aherbez/game2/microgame2.kicad_pcb

## KiCad design microgame2.kicad_pcb (2024-06-25)

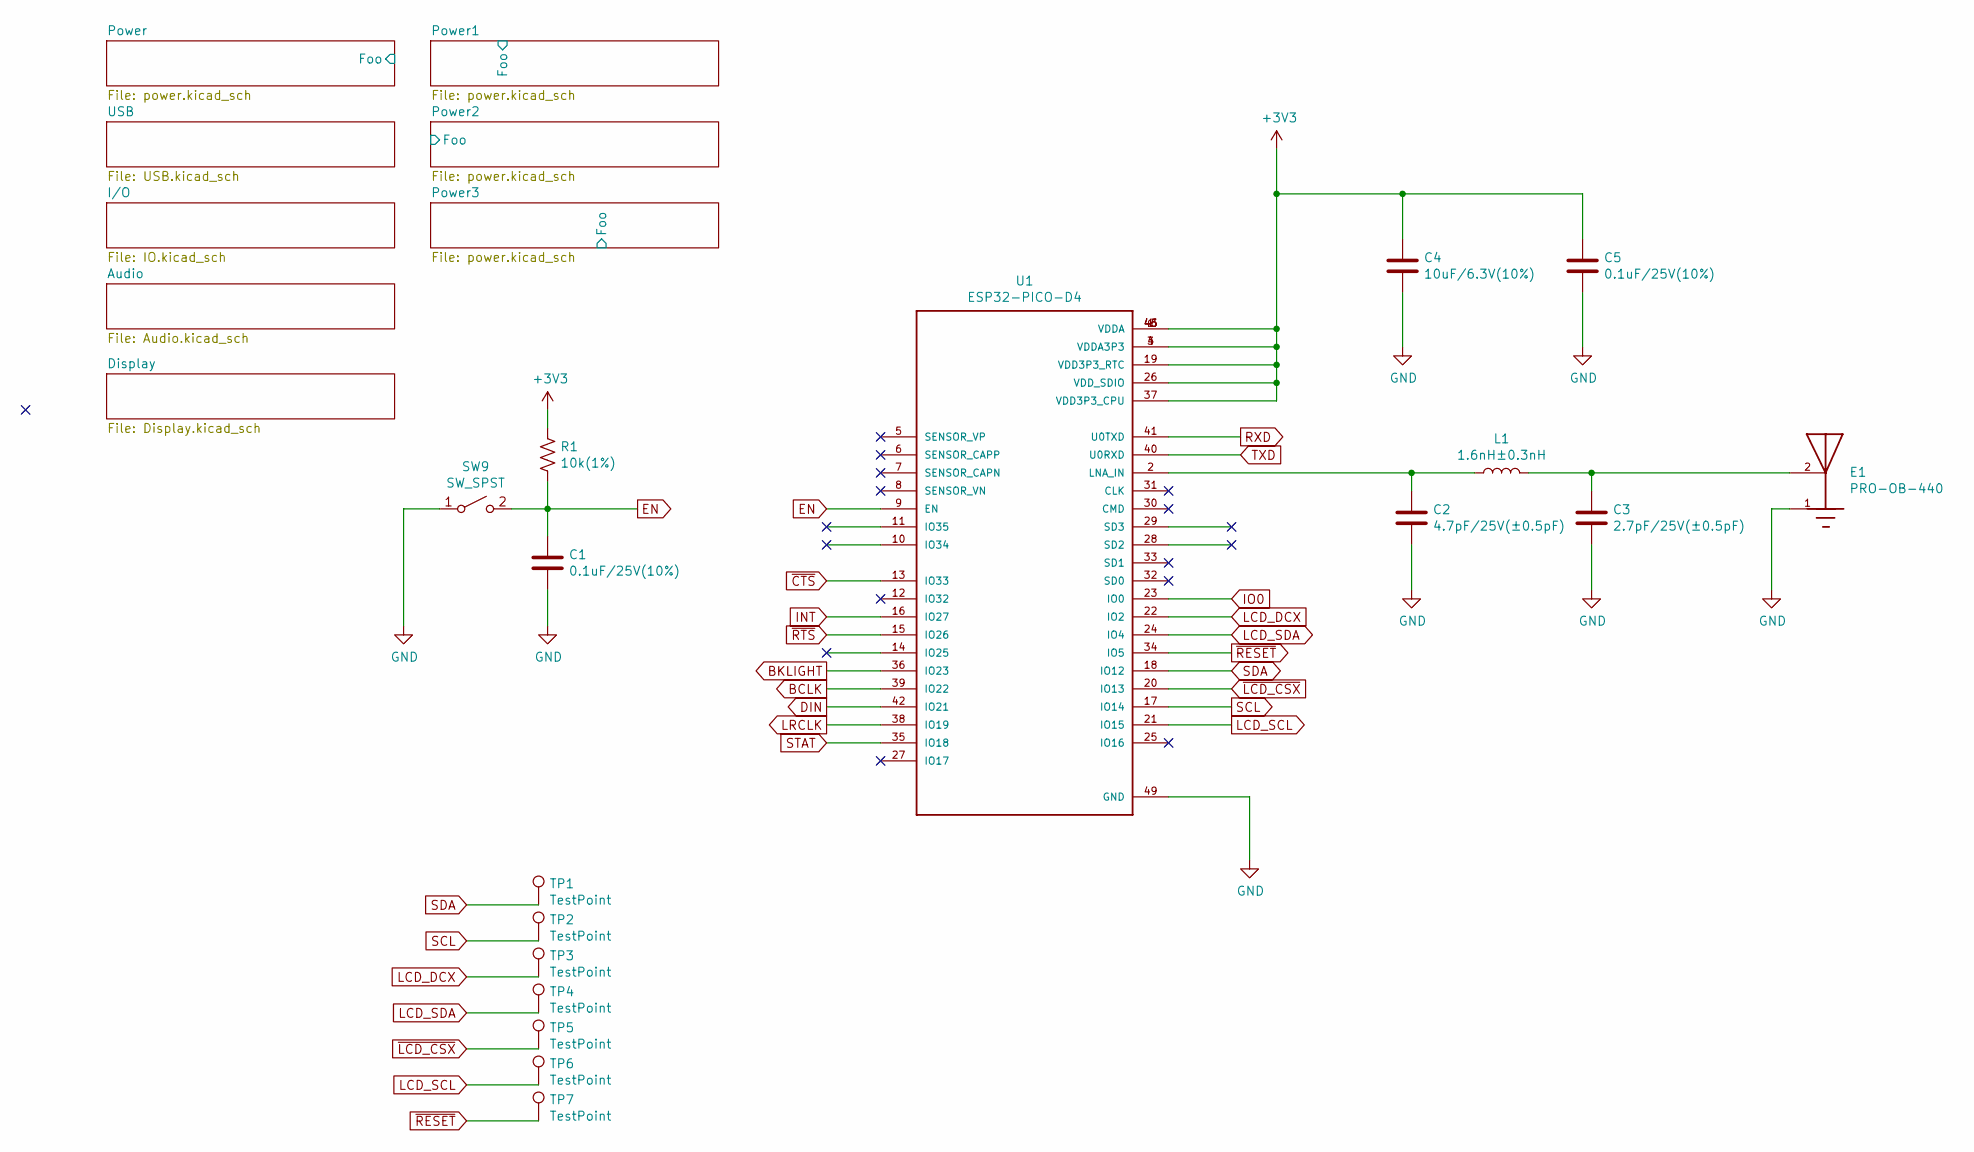
[picture p1: schematic microgame2.kicad_sch]

Parts:
C1, C5: 0.1uF/25V(10%); C_0402_1005Metric
C2: 4.7pF/25V(±0.5pF); C_0402_1005Metric
C3: 2.7pF/25V(±0.5pF); C_0402_1005Metric
C4: 10uF/6.3V(10%); C_0603_1608Metric
E1: PRO-OB-440; ANT_PRO-OB-440
L1: 1.6nH±0.3nH; C_0402_1005Metric
R1: 10k(1%); C_0402_1005Metric
SW9: SW_SPST; EVPAE
TP1, TP2, TP3, TP4, TP5, TP6, TP7: TestPoint; TestPoint_Pad_D1.0mm
U1: ESP32-PICO-D4; PQFN50P700X700X104-49N

Connections:
+3V3: C4.1, C5.1, R1.1, U1.1 (VDDA), U1.3 (VDDA3P3), U1.4 (VDDA3P3), U1.19 (VDD3P3_RTC), U1.26 (VDD_SDIO), U1.37 (VDD3P3_CPU), U1.43 (VDDA), U1.46 (VDDA); also elsewhere on the board
BCLK: U1.39 (IO22); also elsewhere on the board
BKLIGHT: U1.36 (IO23); also elsewhere on the board
DIN: U1.42 (IO21); also elsewhere on the board
EN: C1.1, R1.2, SW9.2 (B), U1.9 (EN); also elsewhere on the board
GND: C1.2, C2.2, C3.2, C4.2, C5.2, E1.1, SW9.1 (A), U1.49 (GND); also elsewhere on the board
INT: U1.16 (IO27); also elsewhere on the board
IO0: U1.23 (IO0); also elsewhere on the board
LCD_DCX: TP3.1, U1.22 (IO2); also elsewhere on the board
LCD_SCL: TP6.1, U1.21 (IO15); also elsewhere on the board
LCD_SDA: TP4.1, U1.24 (IO4); also elsewhere on the board
LRCLK: U1.38 (IO19); also elsewhere on the board
unnamed: C2.1, L1.1, U1.2 (LNA_IN)
unnamed: C3.1, E1.2, L1.2
RXD: U1.41 (U0TXD); also elsewhere on the board
SCL: TP2.1, U1.17 (IO14); also elsewhere on the board
SDA: TP1.1, U1.18 (IO12); also elsewhere on the board
STAT: U1.35 (IO18); also elsewhere on the board
TXD: U1.40 (U0RXD); also elsewhere on the board
~CTS: U1.13 (IO33); also elsewhere on the board
~LCD_CSX: TP5.1, U1.20 (IO13); also elsewhere on the board
~RESET: TP7.1, U1.34 (IO5); also elsewhere on the board
~RTS: U1.15 (IO26); also elsewhere on the board

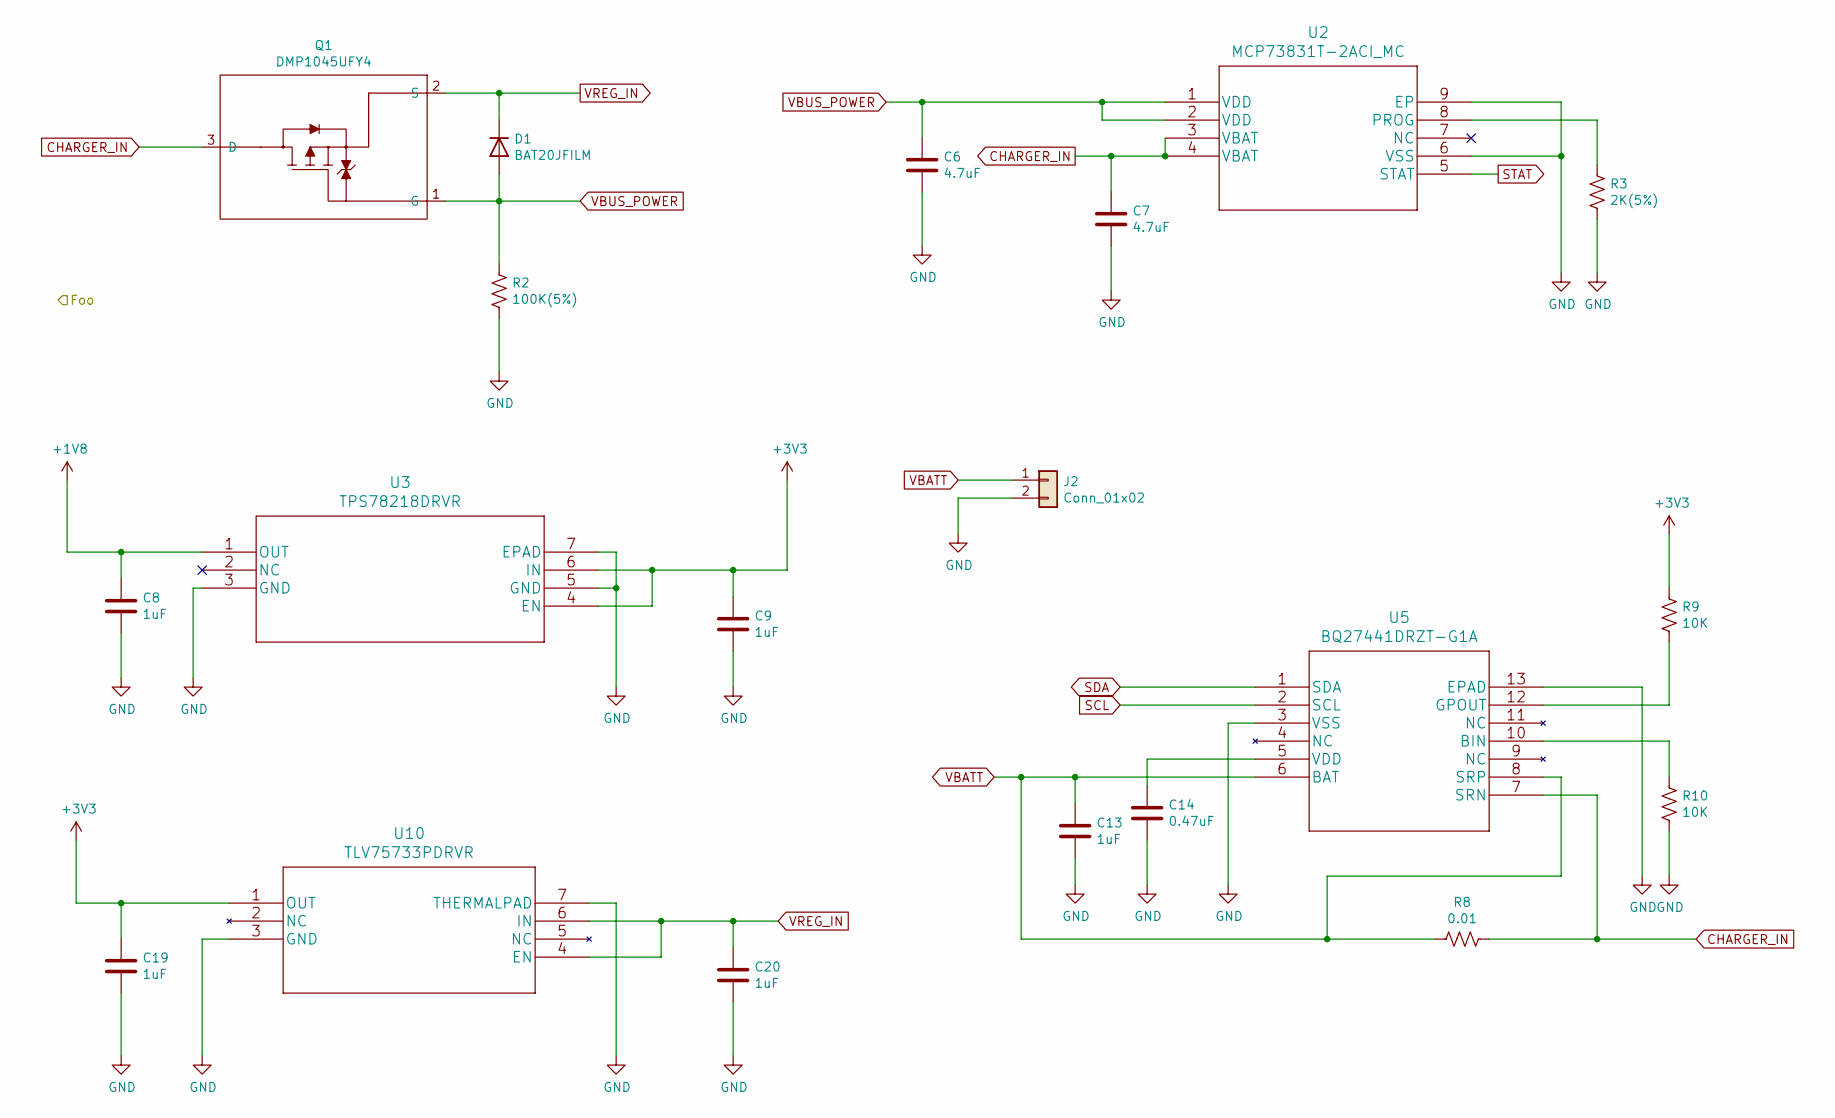
[picture p2: schematic power.kicad_sch]

Parts:
C6, C7: 4.7uF; R_0603_1608Metric
C8, C9, C13, C19, C20: 1uF; R_0603_1608Metric
C14: 0.47uF; R_0402_1005Metric
D1: ‎BAT20JFILM; BAT20JFILM
J2: Conn_01x02; R_1206_3216Metric
Q1: DMP1045UFY4; X2-DFN2015-3
R2: 100K(5%); R_0402_1005Metric
R3: 2K(5%); R_0402_1005Metric
R8: 0.01; R_1206_3216Metric
R9, R10: 10K; R_0402_1005Metric
U2: MCP73831T-2ACI_MC; MCP73831T-2ACI&slash_MC
U3: TPS78218DRVR
U5: BQ27441DRZT-G1A
U10: TLV75733PDRVR

Connections:
+1V8: C8.1, U3.1 (OUT); also elsewhere on the board
+3V3: C9.1, C19.1, R9.1, U3.4 (EN), U3.6 (IN), U10.1 (OUT); also elsewhere on the board
CHARGER_IN: C7.1, Q1.3 (D), R8.1, U2.3 (VBAT), U2.4 (VBAT), U5.7 (SRN)
GND: C6.2, C7.2, C8.2, C9.2, C13.2, C14.2, C19.2, C20.2, J2.2, R2.2, R3.2, R10.2, U2.6 (VSS), U2.9 (EP), U3.3 (GND), U3.5 (GND), U3.7 (EPAD), U5.3 (VSS), U5.13 (EPAD), U10.3 (GND), U10.7 (THERMALPAD); also elsewhere on the board
unnamed: C14.1, U5.5 (VDD)
unnamed: R3.1, U2.8 (PROG)
unnamed: R9.2, U5.12 (GPOUT)
unnamed: R10.1, U5.10 (BIN)
SCL: U5.2 (SCL); also elsewhere on the board
SDA: U5.1 (SDA); also elsewhere on the board
STAT: U2.5 (STAT); also elsewhere on the board
VBATT: C13.1, J2.1, R8.2, U5.6 (BAT), U5.8 (SRP)
VBUS_POWER: C6.1, D1.2 (A), Q1.1 (G), R2.1, U2.1 (VDD), U2.2 (VDD); also elsewhere on the board
VREG_IN: C20.1, D1.1 (K), Q1.2 (S), U10.4 (EN), U10.6 (IN)

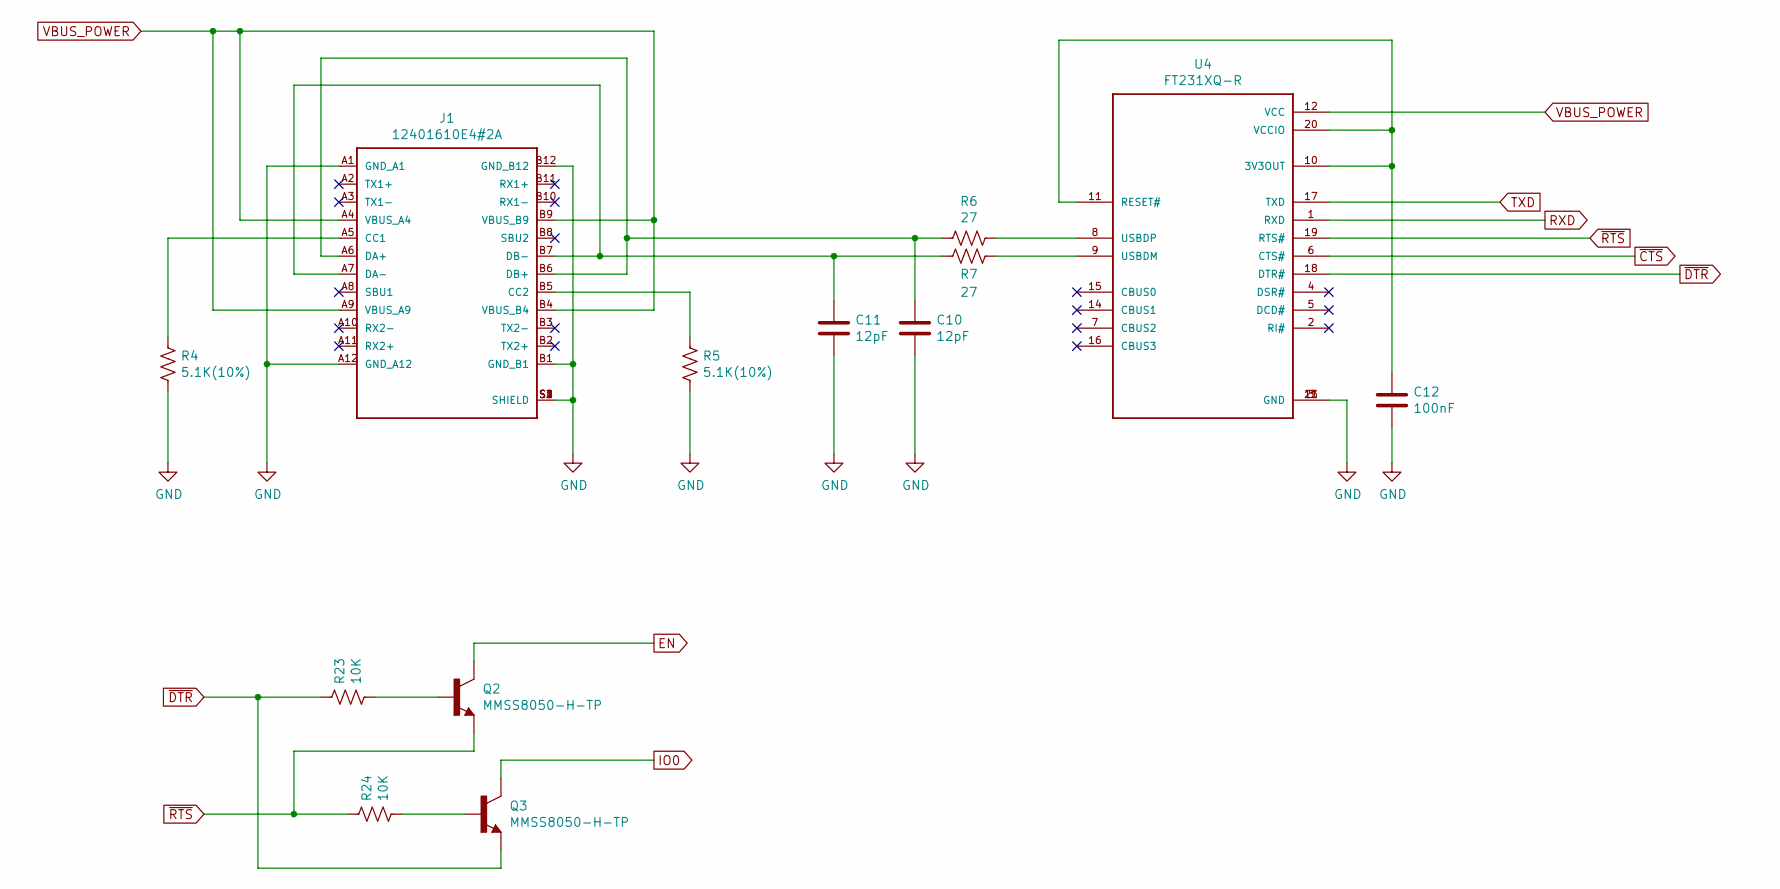
[picture p3: schematic USB.kicad_sch]

Parts:
C10, C11: 12pF; R_0402_1005Metric
C12: 100nF; R_0402_1005Metric
J1: 12401610E4#2A; AMPHENOL_12401610E4#2A
Q2, Q3: MMSS8050-H-TP; TRANS_MMSS8050-H-TP
R4, R5: 5.1K(10%); R_0402_1005Metric
R6, R7: 27; R_0402_1005Metric
R23, R24: 10K; R_0402_1005Metric
U4: FT231XQ-R; QFN50P400X400X80-21N

Connections:
EN: Q2.3; also elsewhere on the board
GND: C10.2, C11.2, C12.2, J1.A1 (GND_A1), J1.A12 (GND_A12), J1.B1 (GND_B1), J1.B12 (GND_B12), J1.S1 (SHIELD), J1.S2 (SHIELD), J1.S3 (SHIELD), J1.S4 (SHIELD), R4.1, R5.1, U4.3 (GND), U4.13 (GND), U4.21 (GND); also elsewhere on the board
IO0: Q3.3; also elsewhere on the board
unnamed: C10.1, J1.A6 (DA+), J1.B6 (DB+), R6.2
unnamed: C11.1, J1.A7 (DA-), J1.B7 (DB-), R7.2
unnamed: C12.1, U4.10 (3V3OUT), U4.11 (RESET#), U4.20 (VCCIO)
unnamed: J1.A5 (CC1), R4.2
unnamed: J1.B5 (CC2), R5.2
unnamed: Q2.1, R23.1
unnamed: Q3.1, R24.1
unnamed: R6.1, U4.8 (USBDP)
unnamed: R7.1, U4.9 (USBDM)
RXD: U4.1 (RXD); also elsewhere on the board
TXD: U4.17 (TXD); also elsewhere on the board
VBUS_POWER: J1.A4 (VBUS_A4), J1.A9 (VBUS_A9), J1.B4 (VBUS_B4), J1.B9 (VBUS_B9), U4.12 (VCC); also elsewhere on the board
~CTS: U4.6 (CTS#); also elsewhere on the board
~DTR: Q3.2, R23.2, U4.18 (DTR#)
~RTS: Q2.2, R24.2, U4.19 (RTS#); also elsewhere on the board

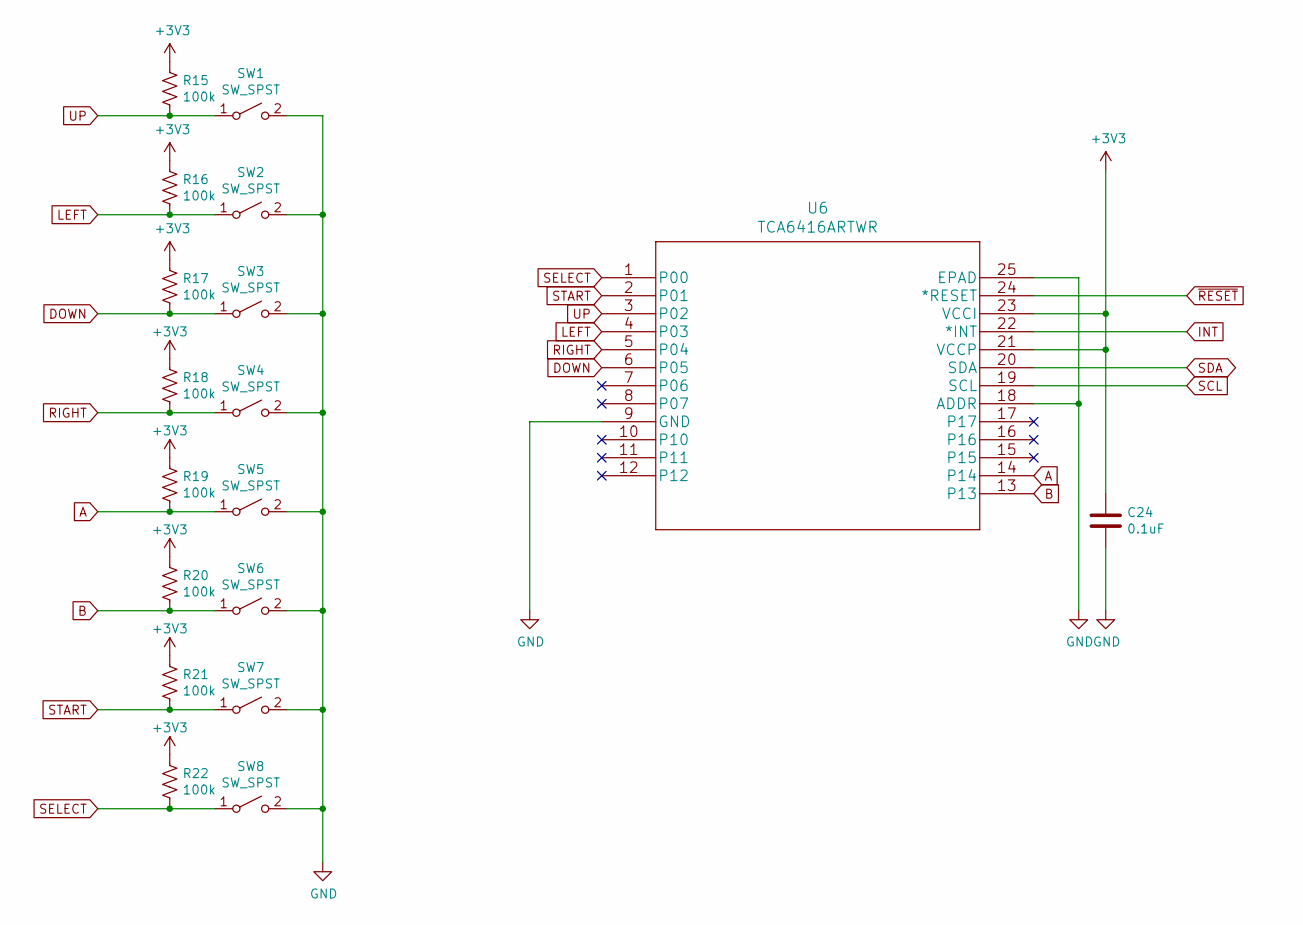
[picture p4: schematic IO.kicad_sch]

Parts:
C24: 0.1uF; C_0402_1005Metric
R15, R16, R17, R18, R19, R20, R21, R22: 100k; R_0402_1005Metric
SW1, SW2, SW3, SW4, SW5, SW6, SW7, SW8: SW_SPST; Button_Pad
U6: TCA6416ARTWR

Connections:
+3V3: C24.1, R15.1, R16.1, R17.1, R18.1, R19.1, R20.1, R21.1, R22.1, U6.21 (VCCP), U6.23 (VCCI); also elsewhere on the board
A: R19.2, SW5.1 (A), U6.14
B: R20.2, SW6.1 (A), U6.13
DOWN: R17.2, SW3.1 (A), U6.6 (P05)
GND: C24.2, SW1.2 (B), SW2.2 (B), SW3.2 (B), SW4.2 (B), SW5.2 (B), SW6.2 (B), SW7.2 (B), SW8.2 (B), U6.9 (GND), U6.18 (ADDR), U6.25 (EPAD); also elsewhere on the board
INT: U6.22 (*INT); also elsewhere on the board
LEFT: R16.2, SW2.1 (A), U6.4 (P03)
RIGHT: R18.2, SW4.1 (A), U6.5 (P04)
SCL: U6.19 (SCL); also elsewhere on the board
SDA: U6.20 (SDA); also elsewhere on the board
SELECT: R22.2, SW8.1 (A), U6.1 (P00)
START: R21.2, SW7.1 (A), U6.2 (P01)
UP: R15.2, SW1.1 (A), U6.3 (P02)
~RESET: U6.24 (*RESET); also elsewhere on the board

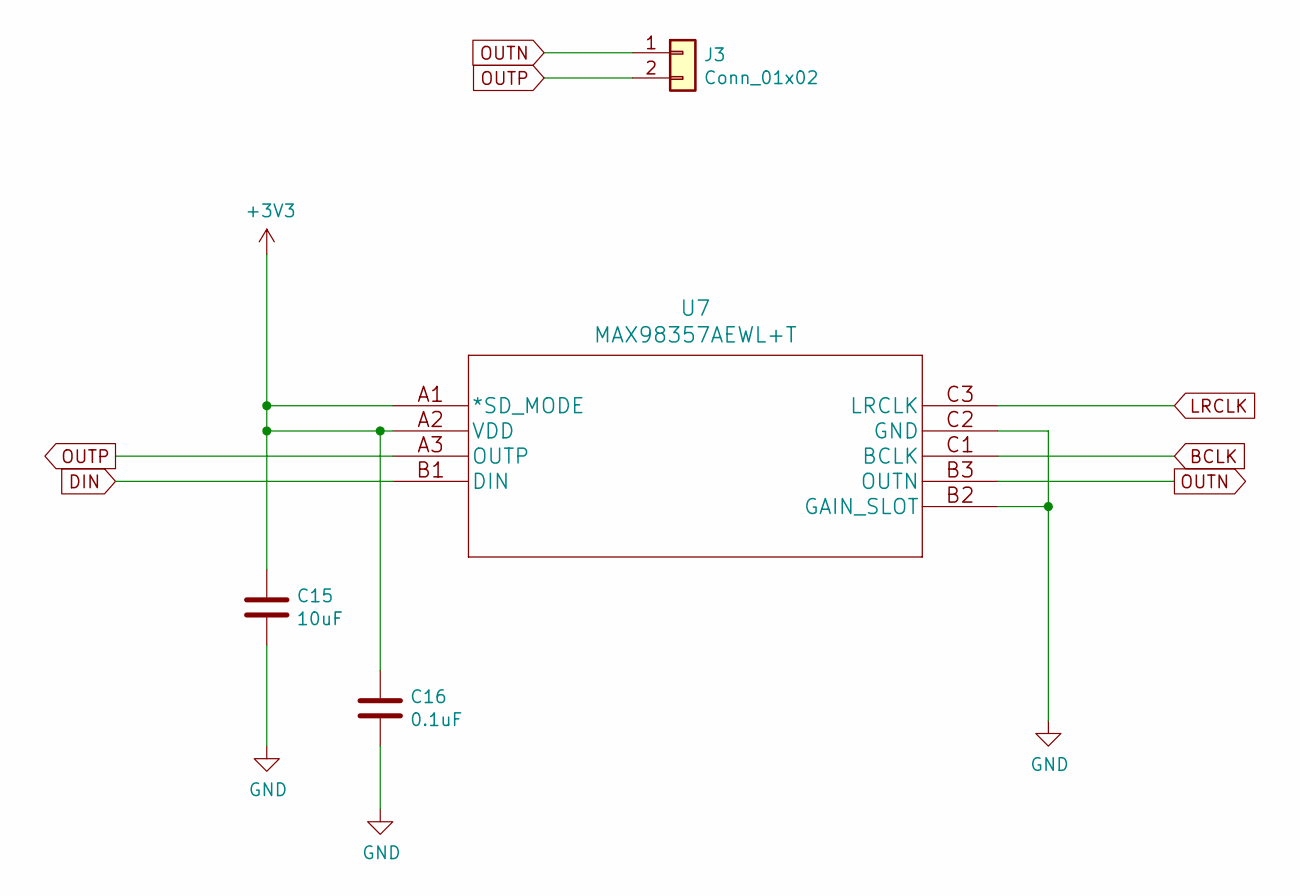
[picture p5: schematic Audio.kicad_sch]

Parts:
C15: 10uF; R_0603_1608Metric
C16: 0.1uF; R_0402_1005Metric
J3: Conn_01x02; R_1206_3216Metric
U7: MAX98357AEWL+T; MAX98357AEWL&plus_T

Connections:
+3V3: C15.1, C16.1, U7.A1 (*SD_MODE), U7.A2 (VDD); also elsewhere on the board
BCLK: U7.C1 (BCLK); also elsewhere on the board
DIN: U7.B1 (DIN); also elsewhere on the board
GND: C15.2, C16.2, U7.B2 (GAIN_SLOT), U7.C2 (GND); also elsewhere on the board
LRCLK: U7.C3 (LRCLK); also elsewhere on the board
OUTN: J3.1, U7.B3 (OUTN)
OUTP: J3.2, U7.A3 (OUTP)

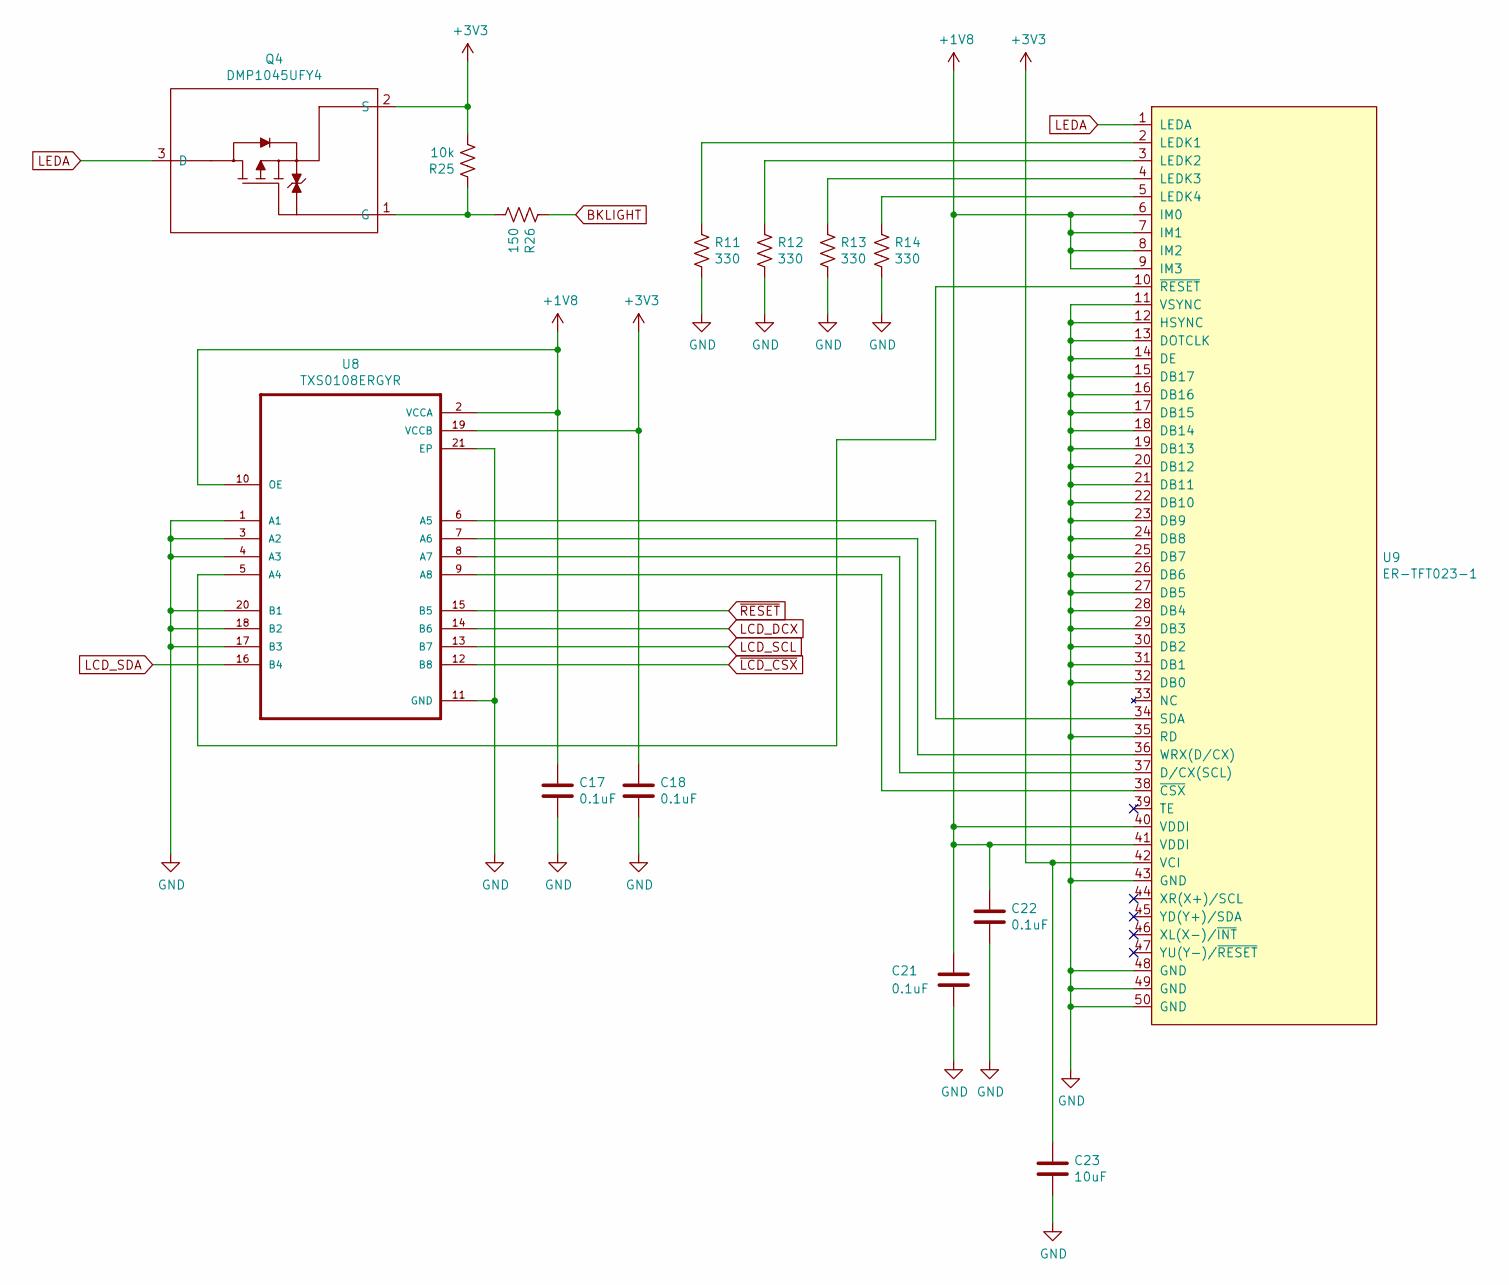
[picture p6: schematic Display.kicad_sch]

Parts:
C17, C18, C21, C22: 0.1uF; R_0402_1005Metric
C23: 10uF; C_0603_1608Metric
Q4: DMP1045UFY4; X2-DFN2015-3
R11, R12, R13, R14: 330; R_0402_1005Metric
R25: 10k; R_0402_1005Metric
R26: 150; R_0402_1005Metric
U8: TXS0108ERGYR; QFN50P450X350X100-21N
U9: ER-TFT023-1; ER-CON50HT-1-INV

Connections:
+1V8: C17.1, C21.1, C22.1, U8.2 (VCCA), U8.10 (OE), U9.6 (IM0), U9.7 (IM1), U9.8 (IM2), U9.9 (IM3), U9.40 (VDDI), U9.41 (VDDI); also elsewhere on the board
+3V3: C18.1, C23.1, Q4.2 (S), R25.2, U8.19 (VCCB), U9.42 (VCI); also elsewhere on the board
BKLIGHT: R26.1; also elsewhere on the board
GND: C17.2, C18.2, C21.2, C22.2, C23.2, R11.2, R12.2, R13.2, R14.2, U8.1 (A1), U8.3 (A2), U8.4 (A3), U8.11 (GND), U8.17 (B3), U8.18 (B2), U8.20 (B1), U8.21 (EP), U9.11 (VSYNC), U9.12 (HSYNC), U9.13 (DOTCLK), U9.14 (DE), U9.15 (DB17), U9.16 (DB16), U9.17 (DB15), U9.18 (DB14), U9.19 (DB13), U9.20 (DB12), U9.21 (DB11), U9.22 (DB10), U9.23 (DB9), U9.24 (DB8), U9.25 (DB7), U9.26 (DB6), U9.27 (DB5), U9.28 (DB4), U9.29 (DB3), U9.30 (DB2), U9.31 (DB1), U9.32 (DB0), U9.35 (RD), U9.43 (GND), U9.48 (GND), U9.49 (GND), U9.50 (GND); also elsewhere on the board
LCD_DCX: U8.14 (B6); also elsewhere on the board
LCD_SCL: U8.13 (B7); also elsewhere on the board
LCD_SDA: U8.16 (B4); also elsewhere on the board
LEDA: Q4.3 (D), U9.1 (LEDA)
unnamed: Q4.1 (G), R25.1, R26.2
unnamed: R11.1, U9.2 (LEDK1)
unnamed: R12.1, U9.3 (LEDK2)
unnamed: R13.1, U9.4 (LEDK3)
unnamed: R14.1, U9.5 (LEDK4)
unnamed: U8.5 (A4), U9.10 (~RESET)
unnamed: U8.6 (A5), U9.34 (SDA)
unnamed: U8.7 (A6), U9.36 (WRX(D/CX))
unnamed: U8.8 (A7), U9.37 (D/CX(SCL))
unnamed: U8.9 (A8), U9.38 (~CSX)
~LCD_CSX: U8.12 (B8); also elsewhere on the board
~RESET: U8.15 (B5); also elsewhere on the board

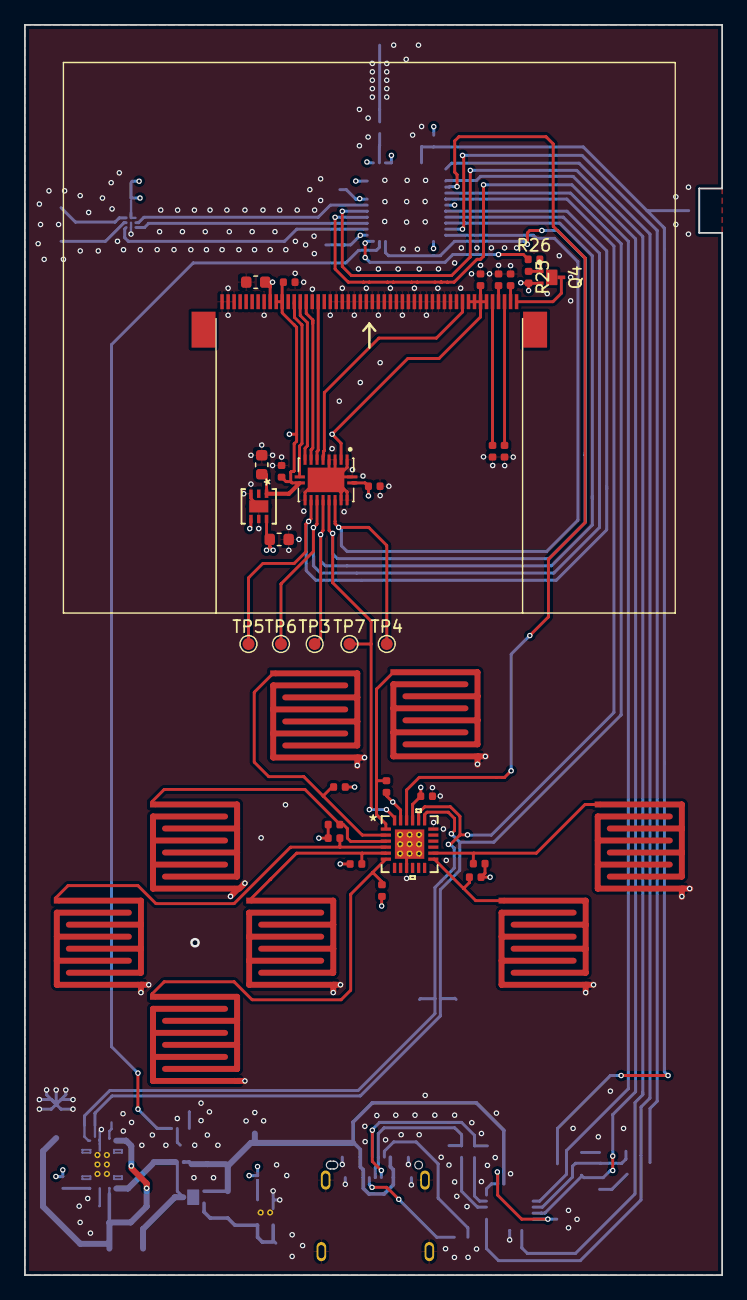
[picture p7: board microgame2.kicad_pcb from above]

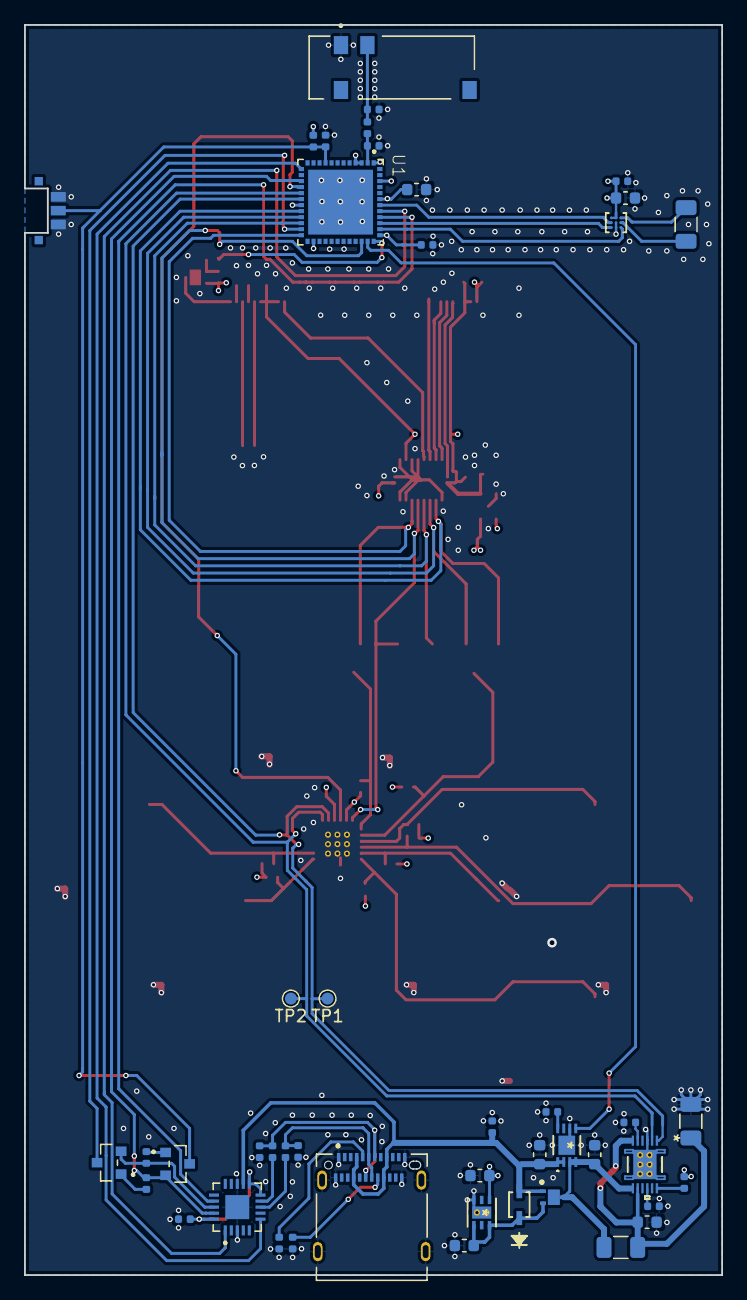
[picture p8: board microgame2.kicad_pcb from below]

Board: 4 copper layers, 58.0 x 104.0 mm, 86 parts (46 on the bottom side), 63 nets.
