aherbez/game2/(commit log)

2024-06-25 initial checkin
    [Audio.kicad_sch, Display.kicad_sch, IO.kicad_sch, USB.kicad_sch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]
2024-06-25 reverting pin movement
    [microgame2.kicad_sch, power.kicad_sch]
